uphyrdia/JupiterPluvius/docs/img/fig3-watering-timeline.png

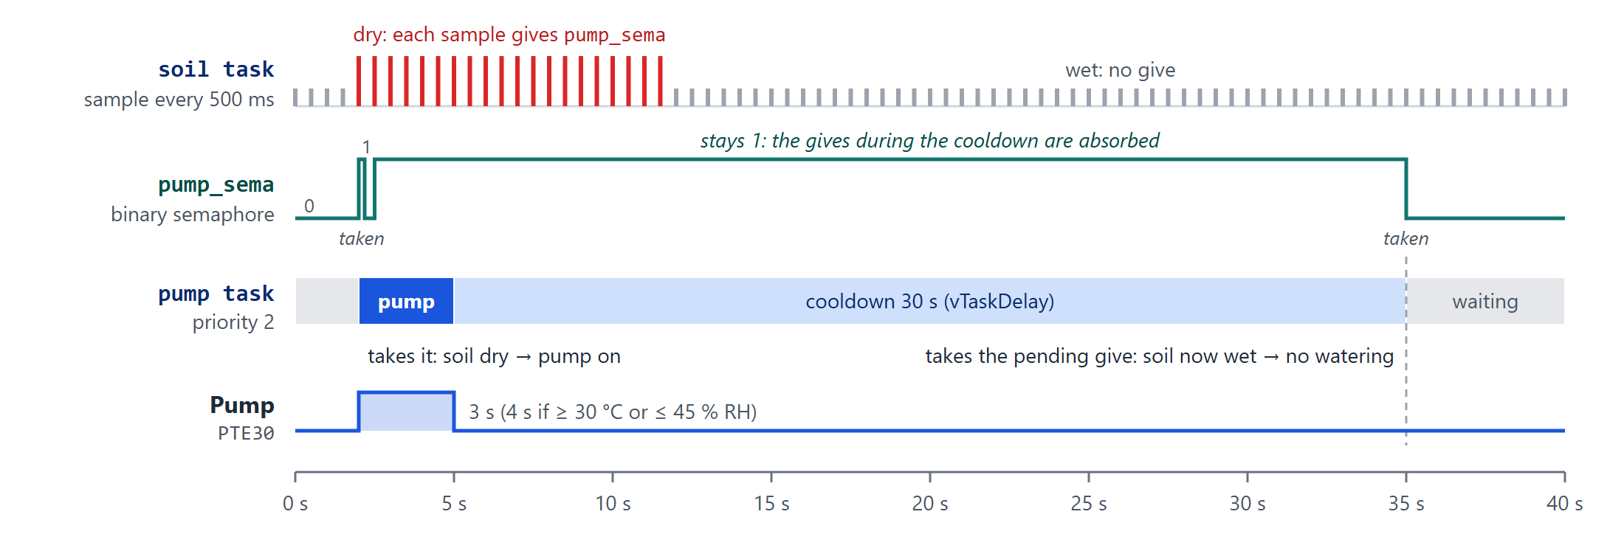
docs/img/fig3-watering-timeline.png
