uphyrdia/JupiterPluvius/docs/img/fig4-servo-fallback.png

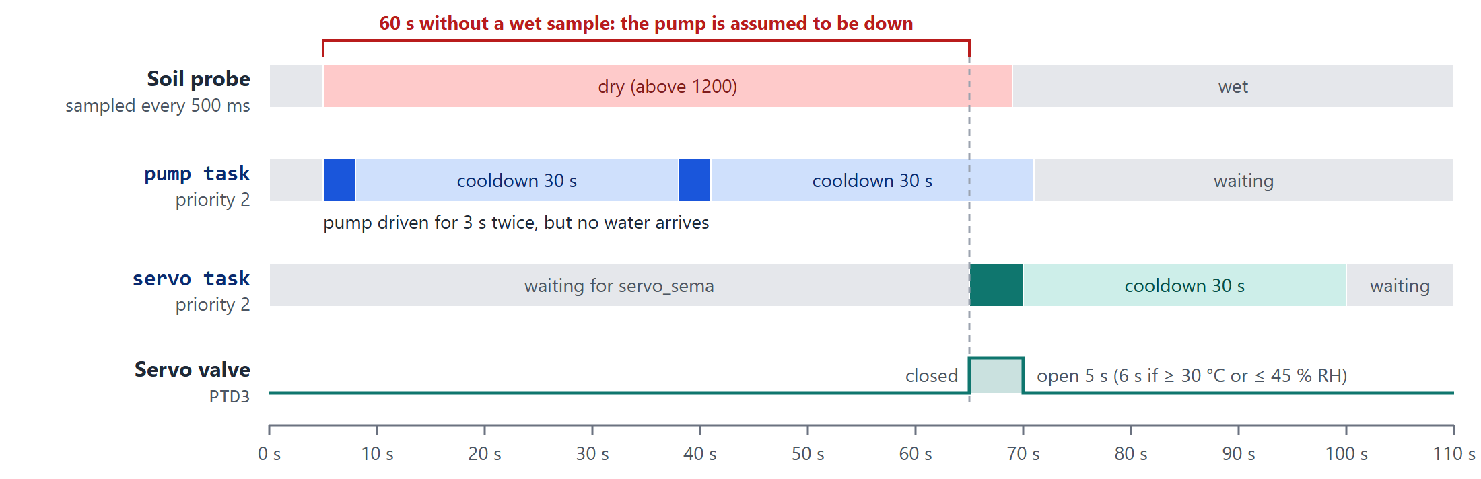
docs/img/fig4-servo-fallback.png
