uphyrdia/JupiterPluvius/docs/img/fig5-uart-send.png

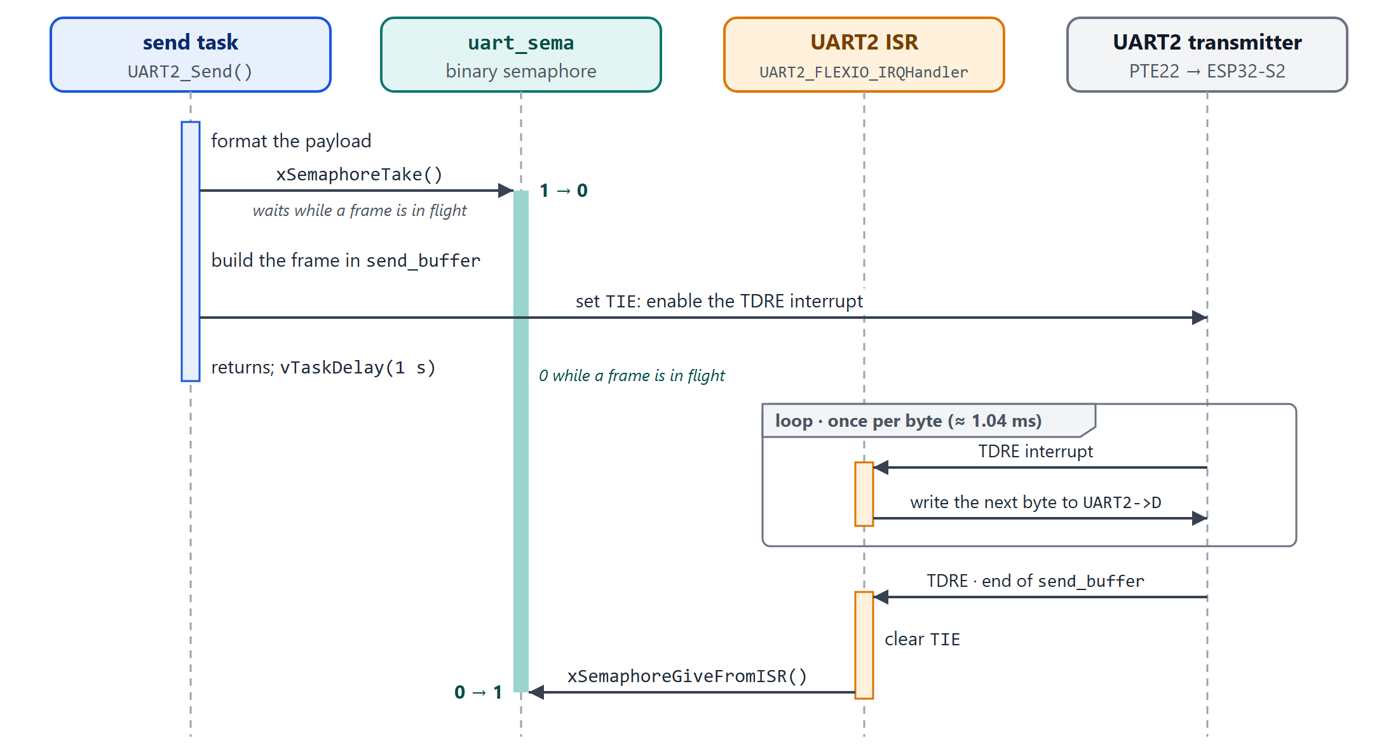
docs/img/fig5-uart-send.png
