uphyrdia/JupiterPluvius/docs/img/fig7-frame-receive.png

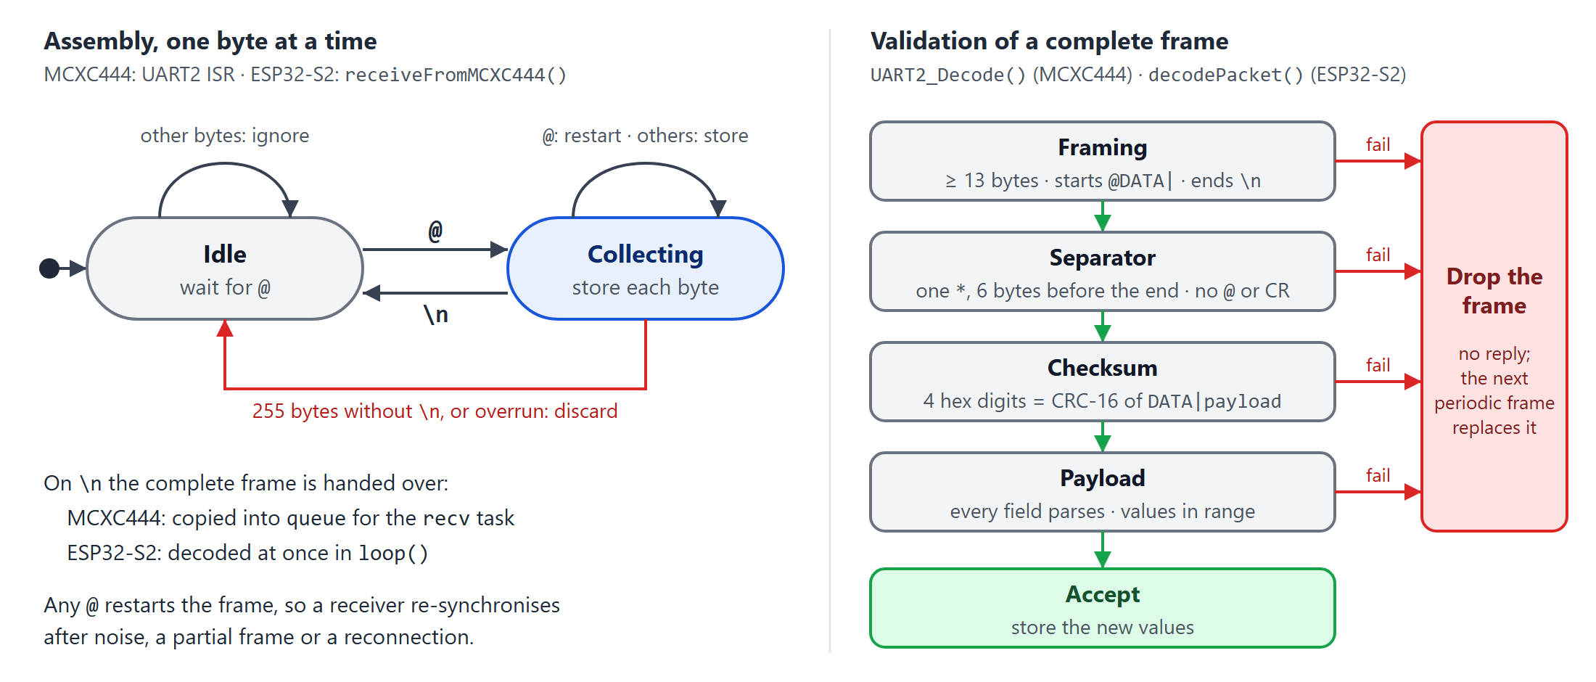
docs/img/fig7-frame-receive.png
