uphyrdia/JupiterPluvius/ESP32/CG2271_Final_Project_ESP32/root_ca_certs.cpp

#include "root_ca_certs.h"

/*
  Public trust anchors from the system CA store: GTS Root R1, R3, R4,
  ISRG Root X1 and X2. These cover common Google/Let's Encrypt TLS chains.
  The project's live chain could not be checked from this environment.
  If its CA changes or uses another issuer, update this PEM block using the
  verified issuing CA's root certificate. Do not disable certificate checks.
*/
const char ROOT_CA_CERTIFICATES[] = R"PEM(
-----BEGIN CERTIFICATE-----
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
bP6MvPJwNQzcmRk13NfIRmPVNnGuV/u3gm3c
-----END CERTIFICATE-----
-----BEGIN CERTIFICATE-----
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
-----END CERTIFICATE-----
-----BEGIN CERTIFICATE-----
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
-----END CERTIFICATE-----
-----BEGIN CERTIFICATE-----
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
-----END CERTIFICATE-----
-----BEGIN CERTIFICATE-----
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
/q4AaOeMSQ+2b1tbFfLn
-----END CERTIFICATE-----
)PEM";
