uphyrdia/JupiterPluvius/cloud_dashboard/esp32/GreenhouseConnectionTest/wifi_config.example.h

#pragma once
// Copy this to wifi_config.h in the same folder. wifi_config.h is ignored by Git.
// Replace only the text inside the parentheses. Raw strings allow quotes/backslashes.
const char* WIFI_SSID = R"wifi(YOUR_HOTSPOT)wifi";
const char* WIFI_PASSWORD = R"wifi(YOUR_PASSWORD)wifi";
const char* BACKEND_URL = "http://YOUR_LAPTOP_IPV4:8000";
