uphyrdia/JupiterPluvius/(commit log)

2026-10-13 Update the interrupt using comparators
2026-10-18 Refactor, add ledTask and servoTask
2026-10-20 Add pump task
2026-10-22 Parse message in recvTask, send data to ESP32 and refactor
2026-10-23 Add source code of ESP32 and bare metal code for comparator
2026-11-02 Add buzzer control and change to external LEDs
    [gpio.c, gpio.h, main.c]
2026-11-02 Add packetization for UART communication
2026-11-03 Updated ESP32 code
2026-11-03 Update ESP32 for database
2026-11-04 Update moisture ADC thresholds
2026-11-05 Modularize esp32 .ino and update frontend
2026-11-05 Fix the joint
2026-11-08 Remove pumping
2026-11-10 Add the remedial servo task
2026-11-10 Add docs, update servo code from lab
